annecrypted/highway-projects/readme.md

# highway 

sorry for all the confusion, each one of my projects for highway is in its own branch so theres like ten in total fml (im rearranging the files that i earlier put tgth before pushing them instead of having them in separate repos which will nuke commit history. sorry but if needed i can do like a tree structure attached to show how its ''supposed to'' be )
