annecrypted/highway-projects/[adv] haestra - corexy printer/bom.md

# bill of materials

## frame + structure

| item | qty | unit cost | total  | notes |
|---|-----|---|---|---|
| 2020 aluminum extrusion (black)  | ~9m | $2.50/m | $23 | 365×365×400 footprint |
| corner brackets (internal) | 20  | $0.15 | $3 | low-profile if enclosing |
| t-nuts (M5 sliding) | 50  | $0.10 | $5 | |
| M5 bolts (various lengths) | — | — | $3 | |
| printed feet | 4 | — | — | printed |
| acrylic panels (3mm, precut) | 4 | $4.00 | $16 | left, right, rear, top |
| front door panel (hinged) | 1 | $6.00 | $6 | optional hinge setup |

**subtotal: ~$56.00**

## motion system

| item | qty | unit cost | total | notes |
|---|-----|---|---|---|
| mgn12 linear rail (400mm) | 2 | $10.00 | $20 | Y rails |
| mgn12 linear rail (300mm) | 1 | $9.00 | $9 | Z rail |
| mgn9 linear rail (200mm) | 1 | $8.00 | $8 | X rail |
| gt2 pulley (20T, 5mm bore)  | 4 | $0.90 | $3.60 | LDO-style |
| idler pulley (smooth, 5mm)  | 6 | $1.00 | $6 | flanged |
| gt2 belt (6mm width) | 5m  | $1.30/m | $6.50 | reinforced |
| t8 lead screw (350mm) | 3 | $3.20 | $9.60 | |
| brass nut (flange style) | 3 | $1.00 | $3 | |

**subtotal: ~$65.70**

## motors + mechanics

| item | qty | unit cost | total | notes |
|---|-----|---|---|---|
| nema17 stepper motor  | 5 | $7.50 | $37.50| 1.5A 40mm body |
| z couplers (5mm–8mm)  | 3 | $1.20 | $3.60 | rigid coupler |
| motor dampers | 2 | $1.20 | $2.40 | for Z |

**subtotal: ~$43.50**

## toolhead + hotend

| item | qty | unit cost | total | notes |
|---|-----|---|---|---|
| dragon hotend clone | 1 | $14.00 | $14 | all-metal, bi-metal throat |
| 5015 blower fan (24v) | 1 | $3.50 | $3.50 | part cooling |
| 4010 axial fan (24v) | 1 | $2.20 | $2.20 | hotend fan |
| thermistor (100k) | 1 | $0.80 | $0.80 | EPCOS B3950 |
| heater cartridge (50W) | 1 | $2.20 | $2.20 | 24V |
| orbiter v2.0 (clone) | 1 | $24.00 | $24 | better gear drive, legit shell |

**subtotal: ~$46.70**

## electronics

| item | qty | unit cost | total  | notes |
|---|-----|---|---|---|
| btt octopus v1.1 | 1 | $34.00 | $34 | 8 driver slots |
| raspberry pi 4 (clone) | 1 | $28.00 | $28 | with microSD + Wi-Fi |
| tmc2209 stepper drivers | 5 | $4.00 | $20 | UART |
| 24v psu (15A) | 1 | $13.00 | $13 | enclosed |
| heated bed (24v, 235×235) | 1 | $12.00 | $12 | aluminum + thermistor |
| endstops (mech) | 3 | $0.90 | $2.70  | simple NO switches |
| external mosfet | 1 | $3.50 | $3.50  | for bed, fanless |
| wiring kit + ferrules | — | — | $6 | silicone 18–22 awg |

**subtotal: ~$119.20**

## misc / enclosure

| item | qty | unit cost | total | notes |
|---|-----|---|---|---|
| silicone bed mat | 1 | $3.00 | $3 | thermal insulation |
| drag chains (optional) | 2 | $3.50 | $7 | 10×15mm |
| panel clips / brackets | 8 | $0.50 | $4 | for acrylic |
| printed ducts / mounts | — | — | — | from printed legion |
| zip ties, kapton, etc | — | — | $3 | general supplies |

**subtotal: ~$17.00**

 final estimate: **~$368.10 USD**
