annecrypted/highway-projects/[adv] haestra - corexy printer/cad/air-management/intake-vents.FCStd

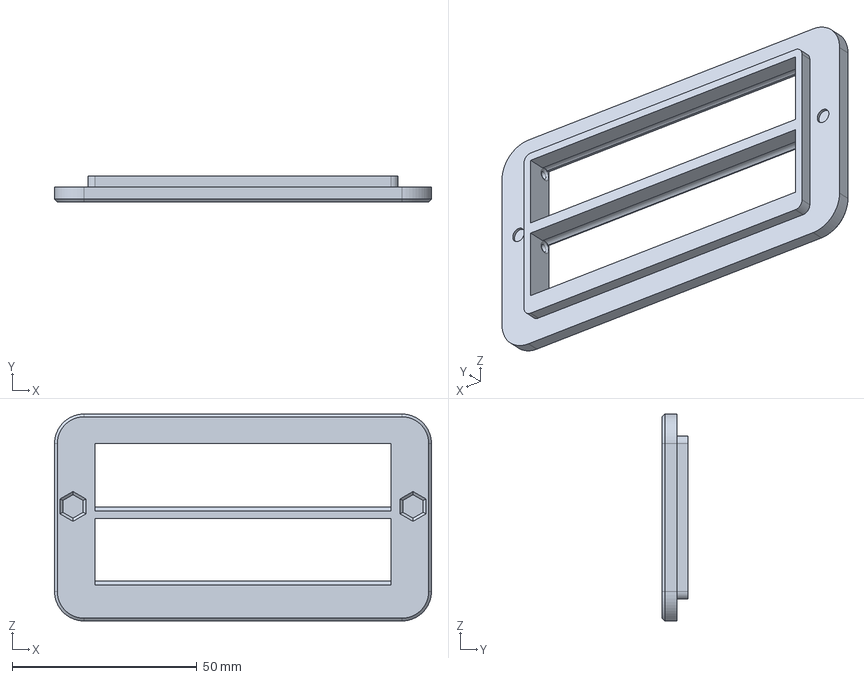
[picture p1: CAD file, 2025-08-02]
[adv] haestra - corexy printer/cad/air-management/intake-vents.FCStd
102.0 x 7.00 x 56.0 mm
