annecrypted/highway-projects/[adv] haestra - corexy printer/cad/electronics/bigtreetech-mini-e3-v2.0.FCStd

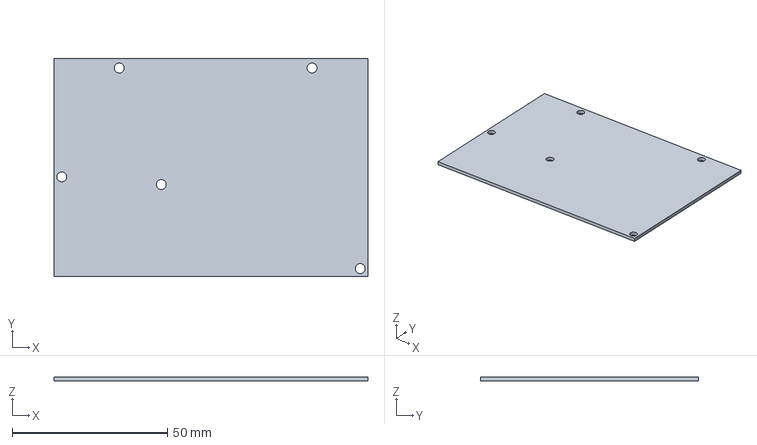
[picture p2: CAD file, 2025-08-02]
[adv] haestra - corexy printer/cad/electronics/bigtreetech-mini-e3-v2.0.FCStd
101.0 x 70.0 x 1.40 mm
