annecrypted/highway-projects/[adv] haestra - corexy printer/cad/general/standard-stuff.FCStd

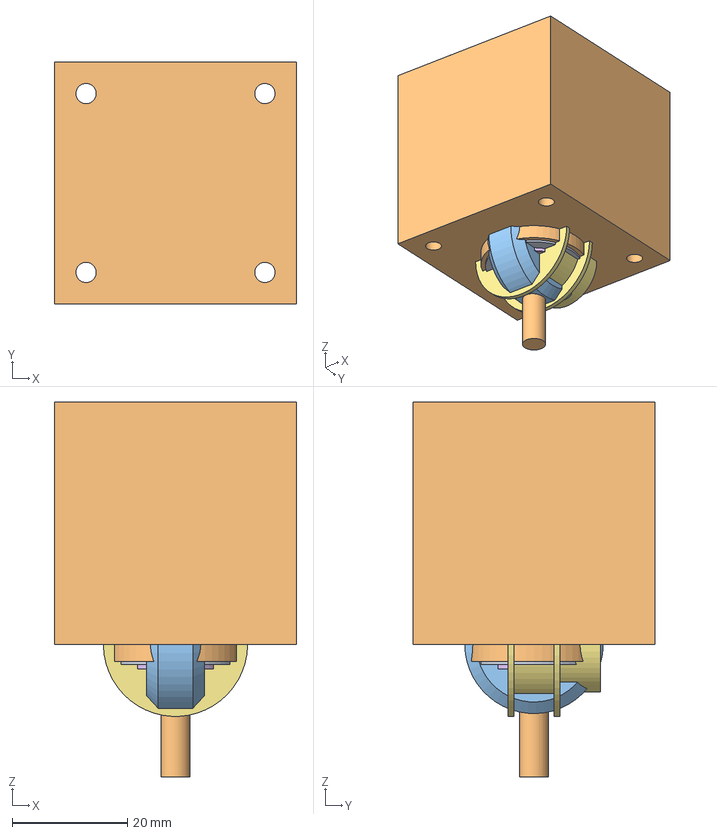
[picture p3: CAD file, 2025-08-02]
[adv] haestra - corexy printer/cad/general/standard-stuff.FCStd
42.0 x 42.0 x 65.0 mm
bearing-608
nema-17
v-wheel
pulley-16t-5mm
pulley-20t-8mm
idler-20t
pulley-32t-8mm
pulley-20t-5mm
