annecrypted/highway-projects/[adv] haestra - corexy printer/cad/y-carriages.FCStd

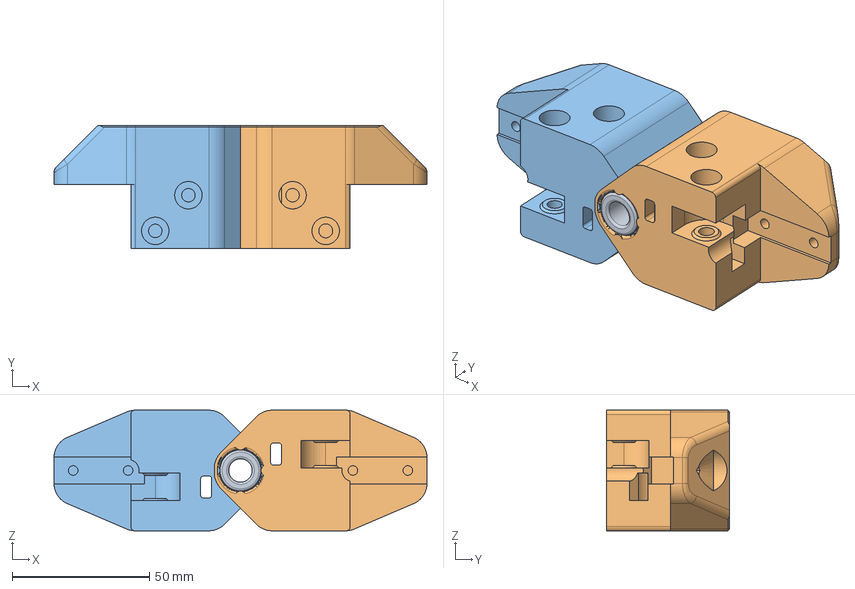
[picture p4: CAD file, 2025-08-02]
[adv] haestra - corexy printer/cad/y-carriages.FCStd
136.0 x 45.0 x 44.0 mm
lm8luu-bearing-drv
y-carriage-left
y-carriage-right
