annecrypted/highway-projects/[adv] haestra - corexy printer/cad/z-motion/mid-drivetrain.FCStd

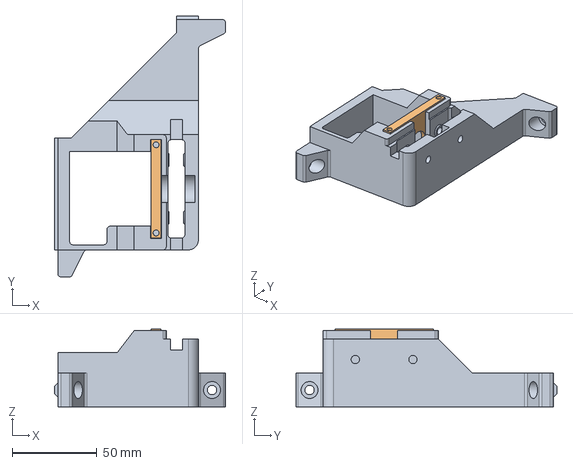
[picture p5: CAD file, 2025-08-02]
[adv] haestra - corexy printer/cad/z-motion/mid-drivetrain.FCStd
101.0 x 154.0 x 46.0 mm
z-motion-mid-drivetrain
z-motion-mid-motor-mount
