annecrypted/highway-projects/[adv] haestra - corexy printer/cad/air-management/air-exhaust.FCStd

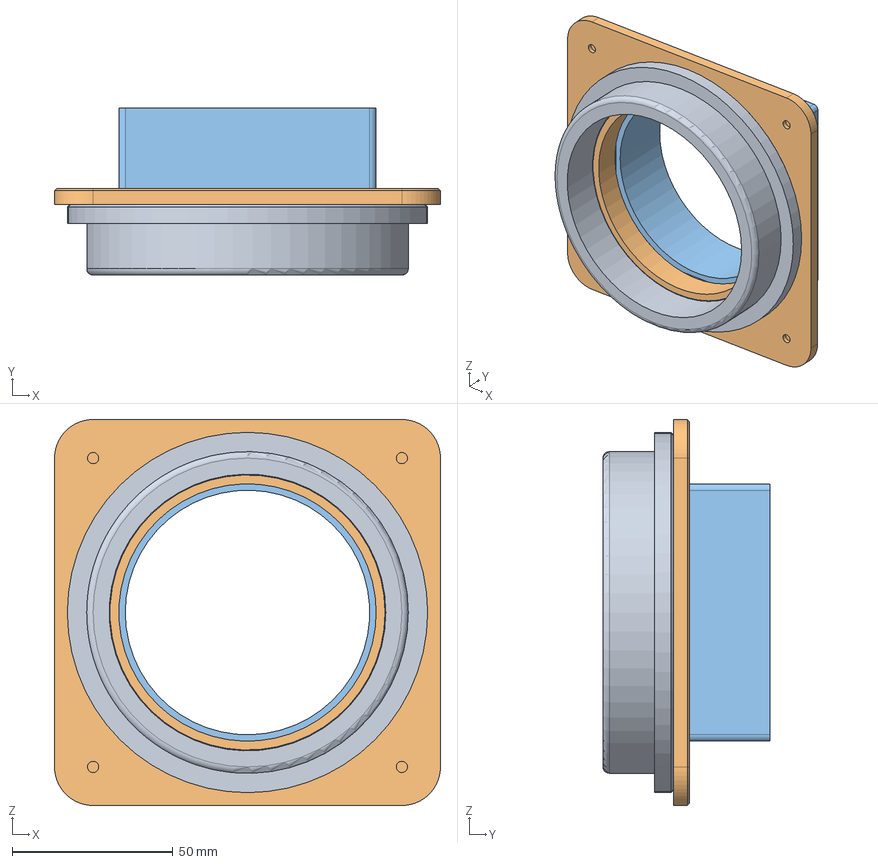
[picture p6: CAD file, 2025-08-02]
[adv] haestra - corexy printer/cad/air-management/air-exhaust.FCStd
120.0 x 52.0 x 120.0 mm
air-connector-hose
air-connector-chamber
exhaust-fan
