annecrypted/highway-projects/[adv] haestra - corexy printer/cad/electronics/PSU-12V-10A.FCStd

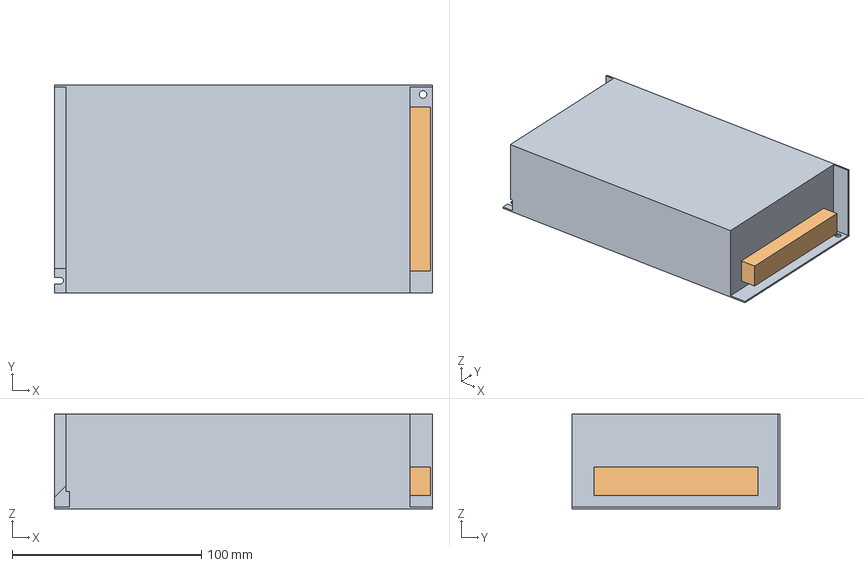
[picture p7: CAD file, 2025-08-02]
[adv] haestra - corexy printer/cad/electronics/PSU-12V-10A.FCStd
200.0 x 110.0 x 50.0 mm
terminal-block
