annecrypted/highway-projects/[adv] haestra - corexy printer/cad/general/belt-clip.FCStd

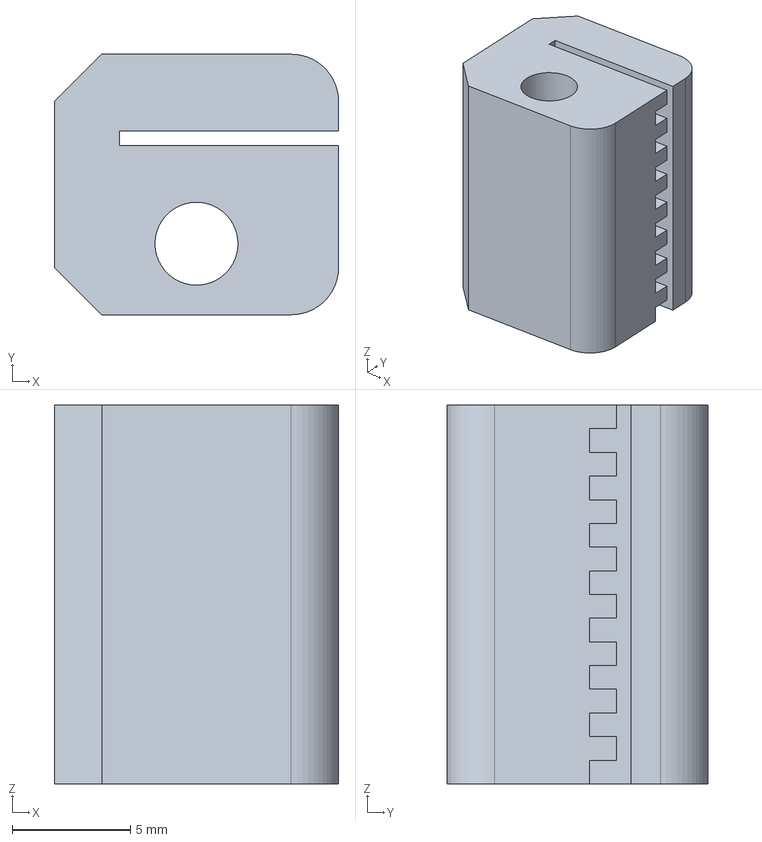
[picture p8: CAD file, 2025-08-02]
[adv] haestra - corexy printer/cad/general/belt-clip.FCStd
12.0 x 11.0 x 16.0 mm
