annecrypted/highway-projects/[adv] haestra - corexy printer/cad/x-carriage.FCStd

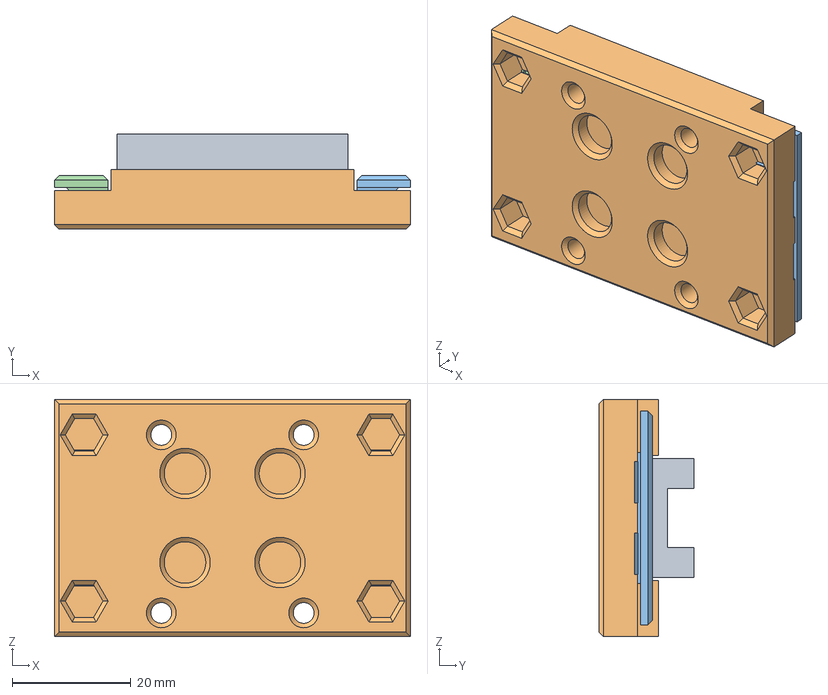
[picture p9: CAD file, 2025-08-02]
[adv] haestra - corexy printer/cad/x-carriage.FCStd
60.0 x 16.0 x 40.0 mm
mgn9h-carriage-x
x-carriage
belt-clamp-right
belt-clamp-left
