annecrypted/highway-projects/[adv] haestra - corexy printer/cad/air-management/chamber-heater.FCStd

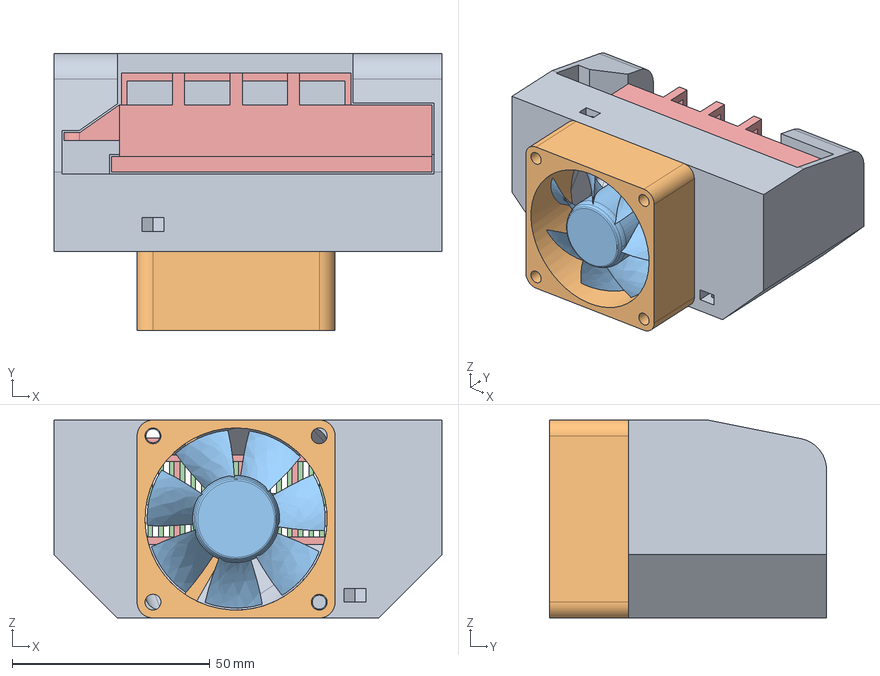
[picture p10: CAD file, 2025-08-02]
[adv] haestra - corexy printer/cad/air-management/chamber-heater.FCStd
98.0 x 70.0 x 50.0 mm
housing
5020-fan-base-drv
5020-fan-rotor-drv
heater-core-drv
heater-case-drv
