annecrypted/highway-projects/[adv] haestra - corexy printer/cad/electronics/pi-zero-2-w.FCStd

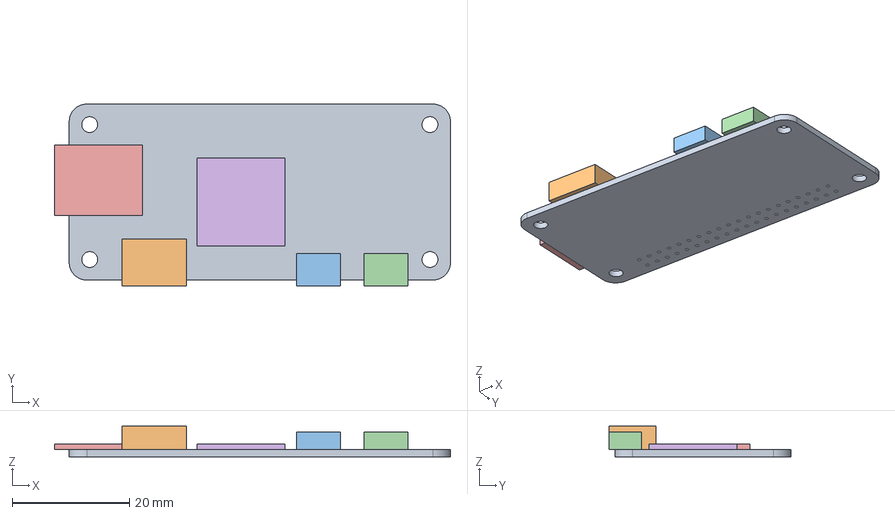
[picture p11: CAD file, 2025-08-02]
[adv] haestra - corexy printer/cad/electronics/pi-zero-2-w.FCStd
67.5 x 31.0 x 5.20 mm
PCB
mini-hdmi
usb-power
usb-data
sd-card-slot
cpu
