annecrypted/highway-projects/[adv] haestra - corexy printer/cad/motor-mounts.FCStd

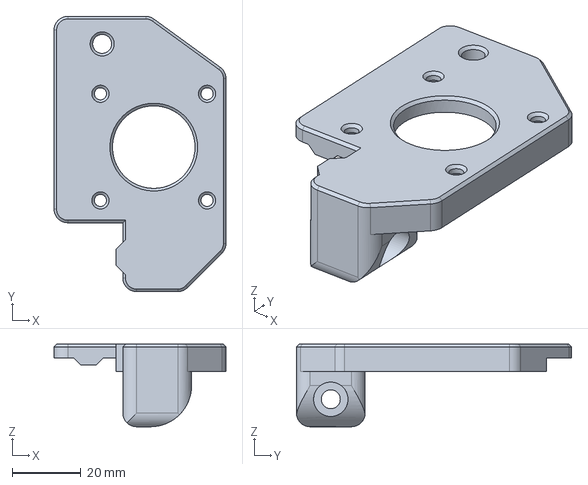
[picture p12: CAD file, 2025-08-02]
[adv] haestra - corexy printer/cad/motor-mounts.FCStd
50.0 x 80.0 x 24.0 mm
