annecrypted/highway-projects/[adv] haestra - corexy printer/img/partial-toolhead.png

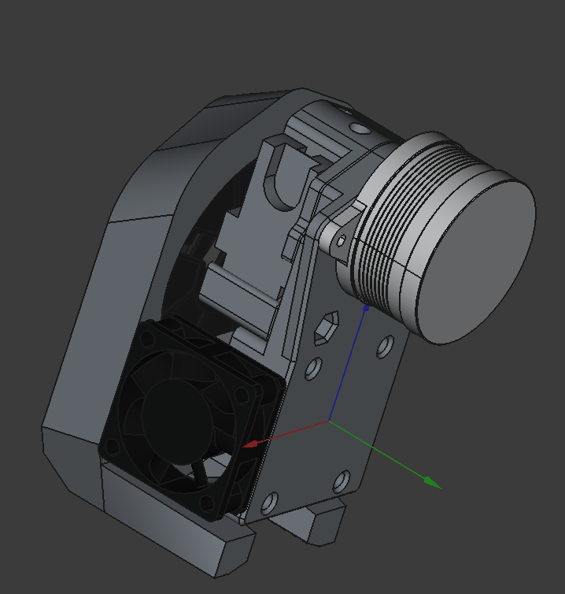
[adv] haestra - corexy printer/img/partial-toolhead.png
