annecrypted/highway-projects/[adv] haestra - corexy printer/img/toolhead2.png

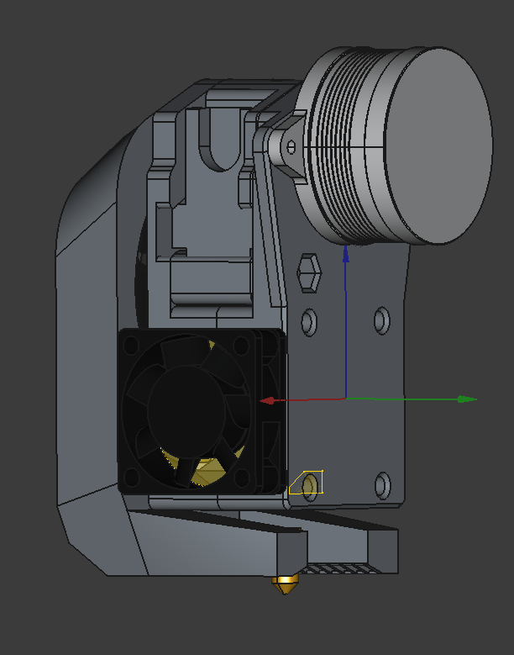
[adv] haestra - corexy printer/img/toolhead2.png
