annecrypted/highway-projects/[adv] haestra - corexy printer/img/toolhead3.png

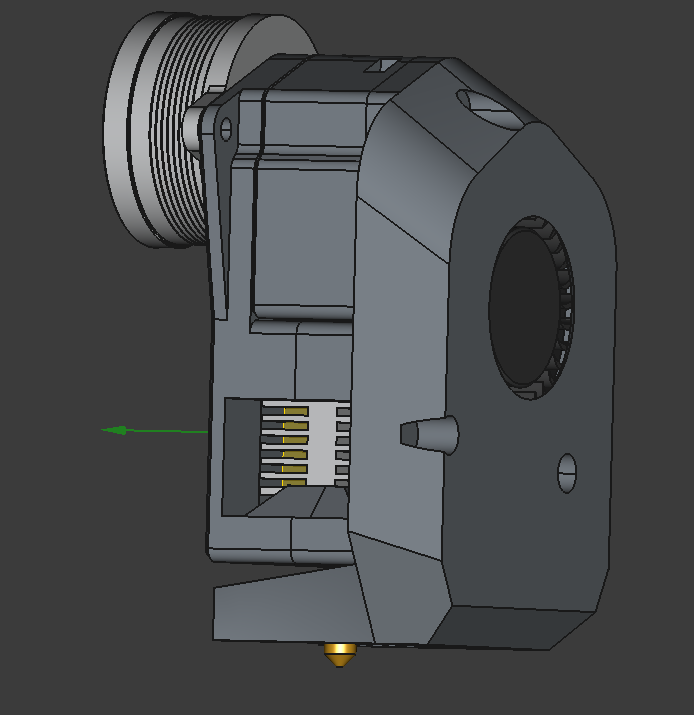
[adv] haestra - corexy printer/img/toolhead3.png
