annecrypted/highway-projects/[adv] haestra - corexy printer/img/xy-gantry.png

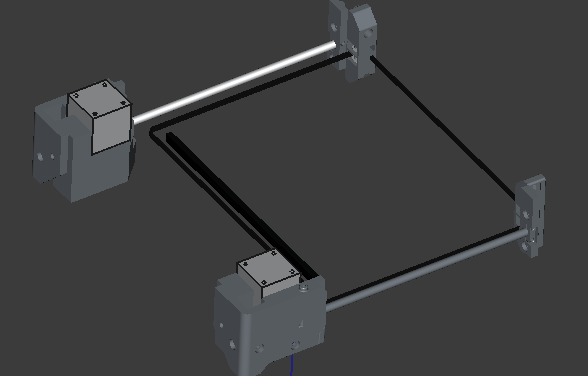
[adv] haestra - corexy printer/img/xy-gantry.png
