annecrypted/highway-projects/[adv] haestra - corexy printer/img/z carriage2.png

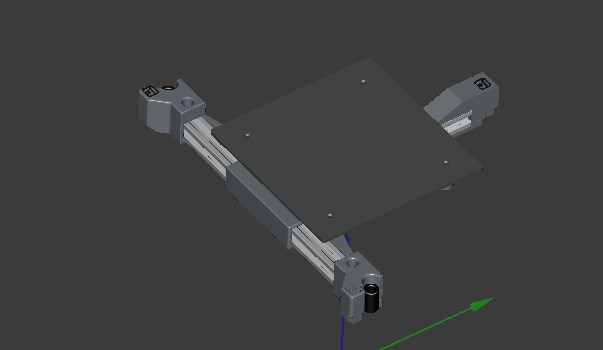
[adv] haestra - corexy printer/img/z carriage2.png
