annecrypted/highway-projects/[adv] haestra - corexy printer/img/z-carriage1.png

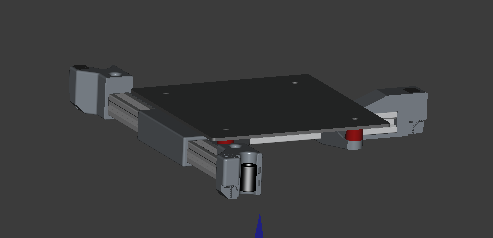
[adv] haestra - corexy printer/img/z-carriage1.png
