annecrypted/highway-projects/(commit log)

2025-06-01 day 01: notes, frame constraints, goals
2025-06-08 firmware test + motion kinematics
2025-07-31 .
    # Conflicts:
    # [adv] haestra - corexy printer/readme.md
